andreas-apg/trayker/README.md

# **Trayker**

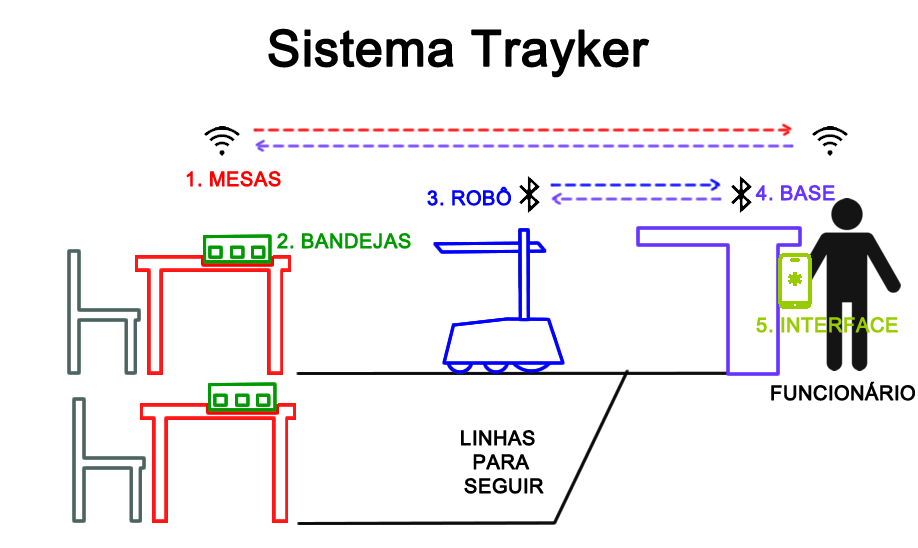
[picture p1: imagens/trayker_simple.png]
Visão geral do projeto


Código para um sistema automatizado de coleta de bandejas para restaurantes e lanchonetes. O sistema é dividido em cinco partes: mesas e bandejas adaptadas, um robô coletor, uma interface web que demonstra em tempo real o estado do robô e mesa e uma estação base, responsável pelo processamento entre as demais partes. [Este vídeo](https://www.youtube.com/watch?v=8xj9Teuq3to) apresenta o sistema em ação.

## **Mesas**

Tendo um [ESP32 da Espressif](https://www.espressif.com/en/products/hardware/esp32/resources) como microcontrolador principal, o código da mesa foi desenvolvido em MicroPython. Ela é responsável por processar dados coletados de diversos sensores e então determinar se a mesa possui uma bandeja abandonada pronta para coleta. Comunicação sem fio com a base é realizada através do protocolo [MQTT](https://mqtt.org/).

## **Robô Coletor**

Possui um [Arduino Mega 2560](https://store.arduino.cc/usa/mega-2560-r3) como microcontroador. Programado em C++, é responsável por guiar o robô até o destino determinado pela estação base, utilizando de um algoritmo seguidor de linha. A comunicação sem fio com a base é realizada através do protocolo Bluetooth.

## **Interface Web**

Hospedada pela estação base, rodando em um servidor web criado por [Flask](http://flask.pocoo.org/) em Python. Apresenta informações em tempo real da leitura dos sensores das mesas, qual mesa o robô está atendendo e a fila de coleta de mesas que já estão prontas para coleta. Seus códigos integram HTML, CSS e Javascript.

## **Estação Base**

Programada em Python, as funcionalidades integradas de Bluetooth e WiFi de uma [Raspberry Pi 3 Model B](https://www.raspberrypi.org/products/raspberry-pi-3-model-b/) foram utilizadas para se comunicar com as mesas e o robô.
