andreas-apg/trayker/imagens/mesa_conexoes.png

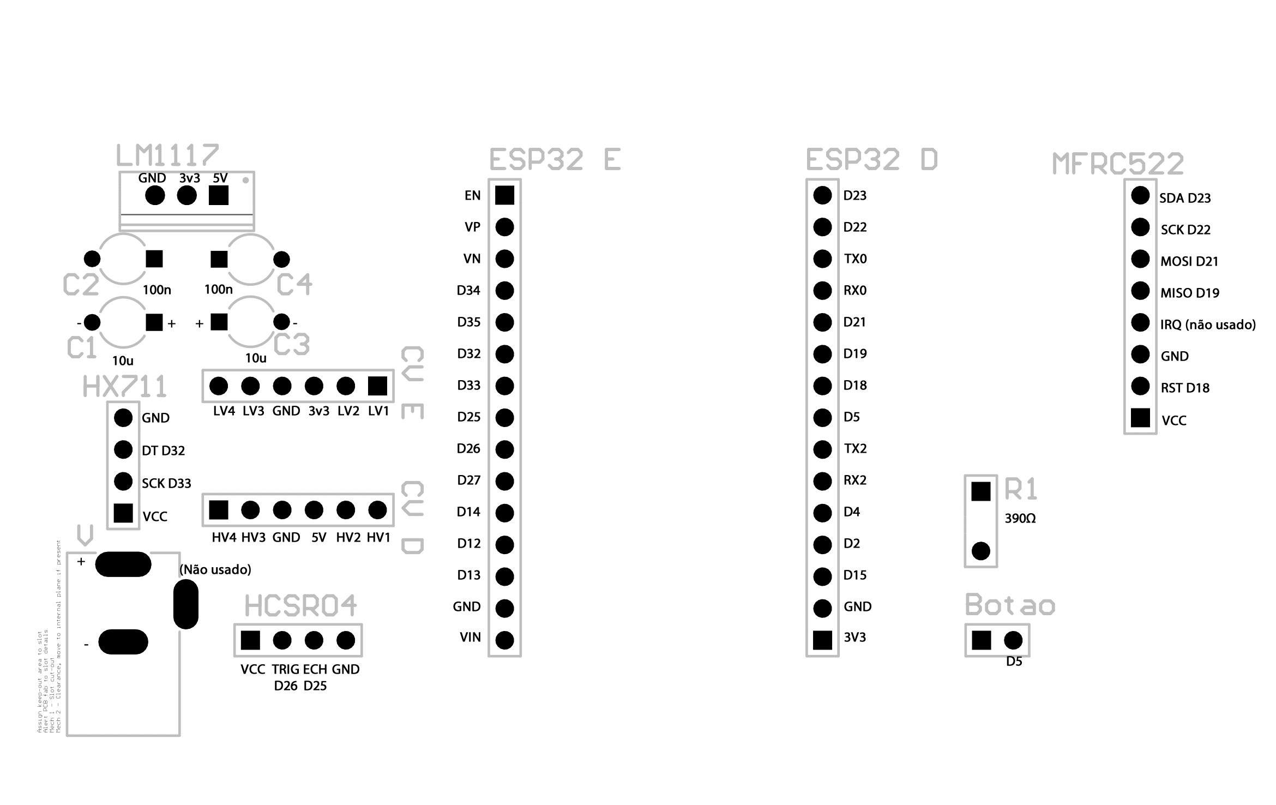
imagens/mesa_conexoes.png
