andreas-apg/trayker/imagens/mesa_pcb.png

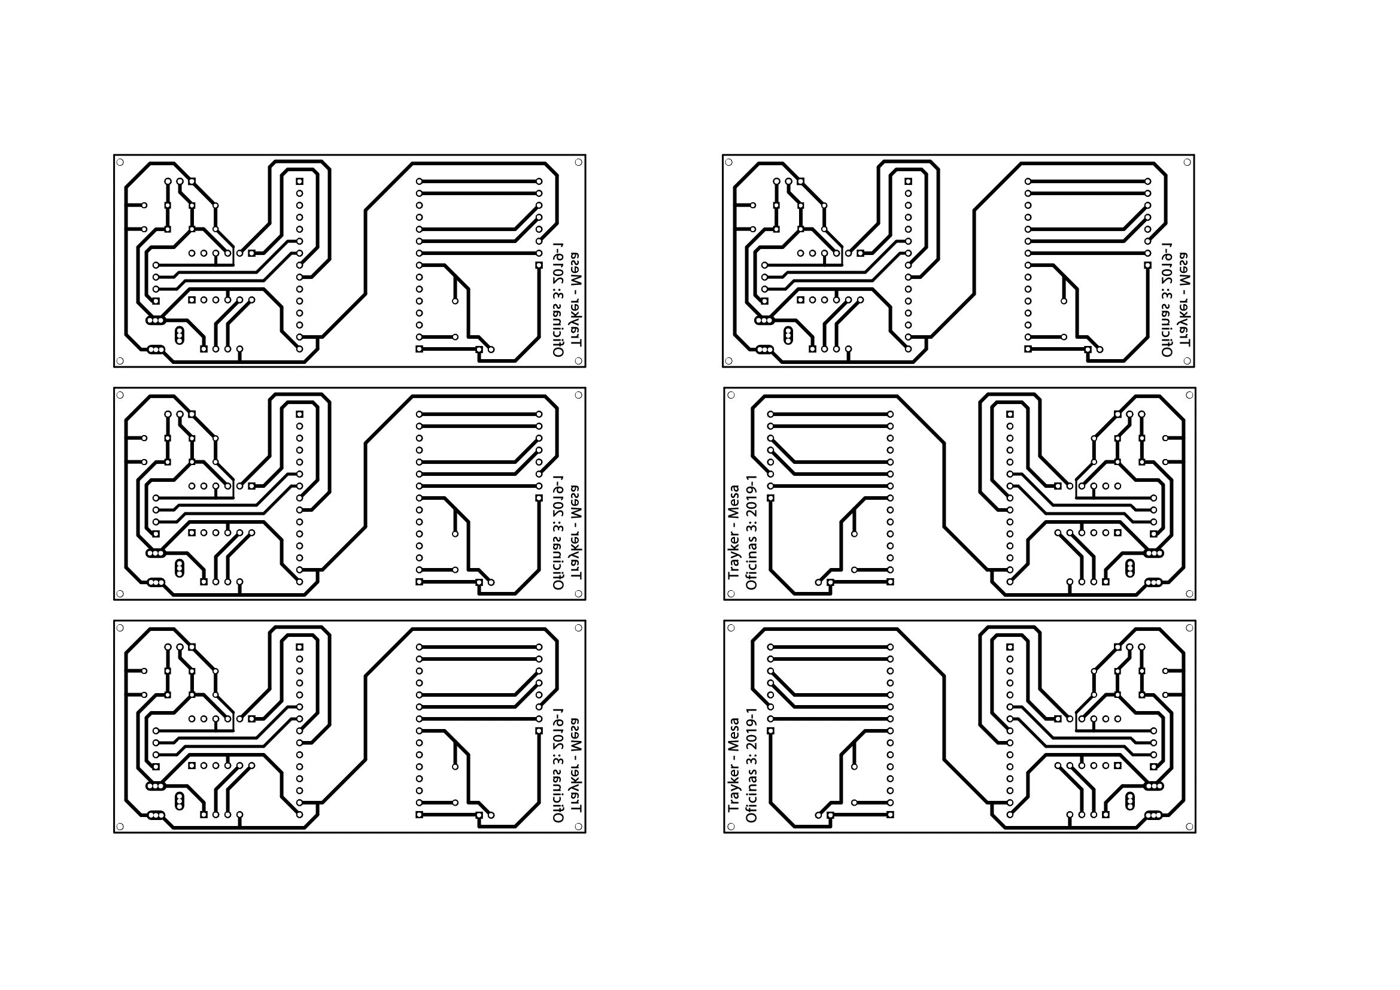
imagens/mesa_pcb.png
