andreas-apg/trayker/esp32/MicroPython/main.py

import net_setup
from time import sleep
from umqtt.robust import MQTTClient
from hcsr04 import HCSR04
import mfrc522
from os import uname
from read import do_read
import machine
from hx711 import HX711
import _thread
import sys
from machine import reset

#MQTT
SERVER = '10.3.141.1'  # MQTT Server Address (Change to the IP address of your Pi)
CLIENT_ID = 'MESA1'
TOPIC = b'mesa1'

client = MQTTClient(CLIENT_ID, SERVER)

try:
    sleep(10)
    print('Conectando...')
    connection = client.connect()   # Connect to MQTT broker
except OSError as er:
    print('Erro na conexao. Reiniciando...')
    reset()
#ULTRASSONICO
sensor = HCSR04(trigger_pin=26, echo_pin=25, echo_timeout_us=10000)
distancia = 0

#BOTAO
pronta = '0'
apertado = '0'
def handle_interrupt(pin):
    global apertado
    if apertado == '0':
        print("Botao apertado.")
        apertado = '1'

bot = machine.Pin(5, machine.Pin.IN, machine.Pin.PULL_UP)
bot.irq(trigger=machine.Pin.IRQ_FALLING, handler=handle_interrupt)

def tratamento_botao():
    global apertado
    try:
        if apertado == '1':
            global pronta
            if(pronta == '1'):
                pronta = '0'
            msg = (b'{0}|{1}|{2:3}|{3:3}|{4:3}'.format(CLIENT_ID, pronta, distancia, str(rfid),peso))
            client.publish(TOPIC, msg)
            print('Cancelamento. Pronta: ' + pronta)
            for i in range (0, 30):
                print('Esperando... ' + str(29 - i))
                if(i % 10 == 0 or i == 0):
                    msg = (b'{0}|{1}|{2:3}|{3:3}|{4:3}'.format(CLIENT_ID, pronta, distancia, str(rfid),peso))
                    client.publish(TOPIC, msg)
                sleep(1)
            apertado = '0'
    except OSError as er:
        apertado = '0'
        print(er.args[0])
        print('Erro no botao')

#HX711: DATA = 32, SCK=33
hx = HX711(32,33)
peso = 0

#RFID:
rfid = '[0, 0, 0, 0]'
def read():
    sleep(2)
    hx.tare()
    print(hx.read())
    sleep(2)
    while True:
        try:
            global rfid
    	    rfid = do_read()
    	    if rfid is None:
    		    rfid = '[0, 0, 0, 0]'
            global distancia
            distancia = sensor.distance_cm()
            global peso
            peso = hx.read()
            # estado pronta = 2 quer dizer que esta so lendo.
            msg = (b'{0}|{1}|{2:3}|{3:3}|{4:3}'.format(CLIENT_ID, 2, distancia, str(rfid),peso))
            #msg = (b'{0}|{1:3}|{2:3}|{3:3}'.format(pronta, distancia, str(rfid), peso))
            client.publish(TOPIC, msg)  # Publish sensor data to MQTT topic
            print(msg)
        except OSError as er:
            print(er.args[0])
            print('Erro na coleta.')
            continue
        sleep(1)

# Funcao responsavel por informar a base se a mesa esta pronta.
# Checa 30 vezes, com intervalo de 1 segundo entre cada chamada,
# se as condicoes de prontidez foram atendidas (distancia > 45 cm,
# peso < 315 g e se detectou uma tag RFID).
# Se todas as 30 iteracoes tinham o estado pronta = 1, manda para
# a base. Se pronta foi de 1 para 0, tambem avisa a base.
def waiting():
    global pronta
    pronta = '0'
    while True:
        try:
            for i in range (0, 10):
                anterior = pronta
                confirma = 0
                pronta = waiting_check()
                print('Pronta: {}\nEsperando... {}'.format(pronta, i))
                # se apertou o botao, precisa avisar
                # instantaneamente que tem que ir pra
                # nao pronta e espera 30 segundos para
                # voltar a checar o estado. Isso e feito
                # na funcao tratamento_botao.
                if(apertado == '1'):
                    tratamento_botao()
                    break
                # se mudou de estado, precisa comecar a
                # contar de novo
                if(anterior != pronta):
                    break
                if(i == 9):
                    confirma = 1
                sleep(1)
            # se passou 10 segundos dentro de um mesmo estado,
            # manda pra base o estado
            print('Esperou {} segundos.'.format(i))
            if (confirma == 1):
                print('Mandando pra base:')
                msg = (b'{0}|{1}|{2:3}|{3:3}|{4:3}'.format(CLIENT_ID, pronta, distancia, str(rfid),peso))
                client.publish(TOPIC, msg)
                print(msg)
        except OSError as er:
            print(er.args[0])
            print('Erro na espera')
            continue


# Funcao chamada por waiting para checar as condicoes de estado.
def waiting_check():
    if(distancia > 35 and peso < 315 and rfid != '[0, 0, 0, 0]'):
        return '1'
    return '0'

def working():
     _thread.start_new_thread(read, ())
     _thread.start_new_thread(waiting, ())

working()
#_thread.start_new_thread(working(), ())
#working()
