andreas-apg/trayker/(commit log)

2019-04-14 Project created. Added current MicroPython progress.
2019-04-15 Adicionado driver de RFID que funciona.
2019-04-24 Added hx711 driver.
2019-05-19 Merging ultrasonic, RFID and button
2019-06-05 Modificações no MQTT. Adicionado controle de estado.
2019-06-05 Tratamento de erro adicionado à mesa.
2019-06-11 Mesa: umqtt robust implementado. Base: mqtt comunicando com múltiplas mesas, servidor adicionado.
    [partitions_mpy.csv]
2019-06-12 Base: página html adicionada. Classe da fila de tarefas criada.
2019-06-16 wip de sabado
2019-06-17 Arduino: fator de velocidade e comunicacao com a base.
2019-06-17 Arduino: ajuste de velocidade
2019-06-17 Base: interface letras e atendendo; informacao de inicializando
2019-06-26 Imagens para descricao do projeto adicionadas.
2019-06-29 versao nova com seguidor de linha re
2019-06-29 commit com o seguidor de linha re
2019-06-29 Mesa: arrumada espera no RFID. Estado 2 criado para funcao de coleta de dados. Base: Funcoes adaptadas para funcionarem com N mesas.
2019-06-30 Utilizar motor C para dar ré; Codigo normal;
2019-06-30 retirado aquilo que nunca existiu, adicionado tempo de espera ao chegar na cozinha,
2019-06-30 base: adicionado mensagem de peso pro robo, adicionado mensagem 2
2019-07-10 Imagens da PCB da mesa adicionadas.
2019-07-10 adicionado PCB da robô
